kfilipekk/fpga_gps_clock/README.md

# FPGA GPS Clock



A GPS-disciplined OCXO with a picosecond time-to-digital converter on a £15 Sipeed Tang Nano 9K (Gowin GW1NR-9C), built only with open source tools (yosys, nextpnr, apicula, cocotb and SymbiYosys). Made by Krystian Filipek.

## In Plain Terms

Every electronic device keeps time with a tiny vibrating crystal, but cheap crystals drift: they run slightly fast or slow, and change when the temperature changes. This clock checks itself against GPS satellites, which carry atomic clocks, and constantly corrects a much better crystal kept inside a tiny heated oven. Over almost 18 hours its rate wandered by only about one part in three billion, the same as drifting a second every hundred years, from a £15 board and a £4 oscillator.

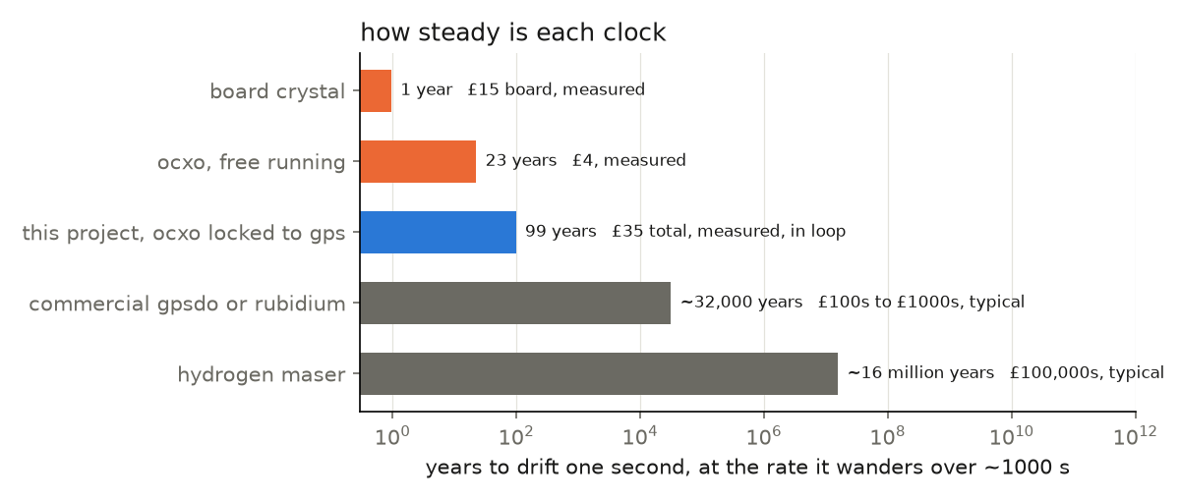
[picture p1: docs/img/compare.png]
How steady is each clock


The board's own crystal also runs about 5 parts per million slow, around 13 seconds a month, about as good as a Casio digital watch (specified to ±30 seconds a month). A fixed offset like that can be measured and corrected, and locked to GPS the OCXO has none. What matters is how much the rate wanders, which is what the chart compares. The orange and blue bars are measured; the grey ones are typical figures for commercial references, for scale.

<div align="center">

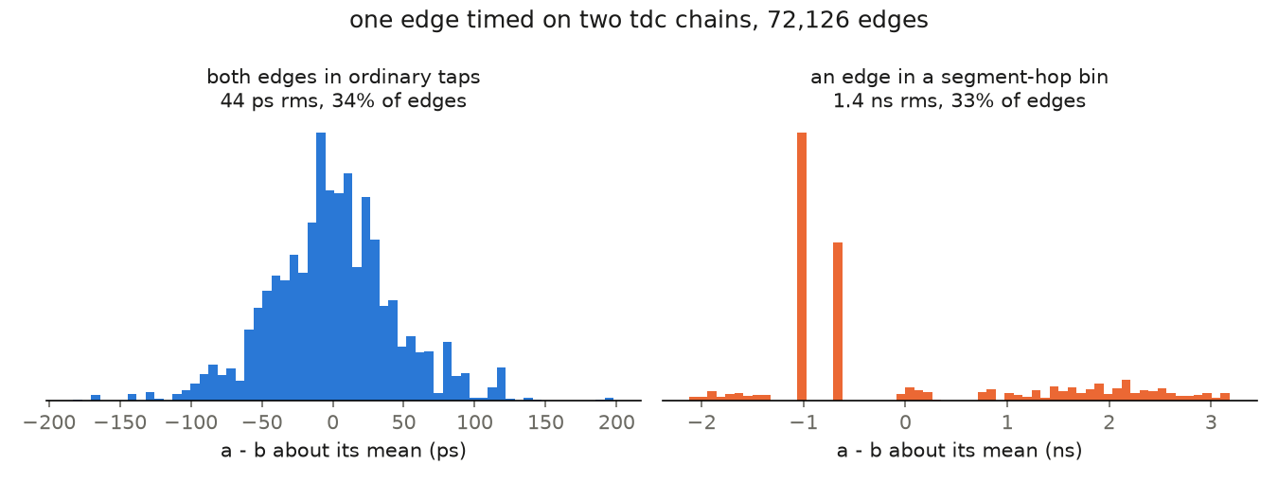
[picture p2: docs/img/tic-precision.png]
Single-shot Precision

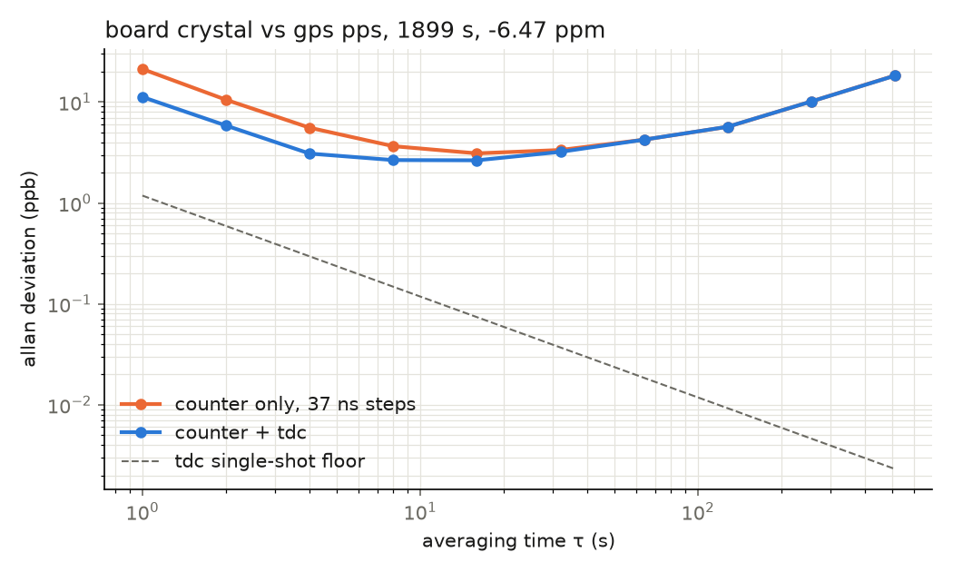
[picture p3: docs/img/pps-adev.png]
Allan Deviation

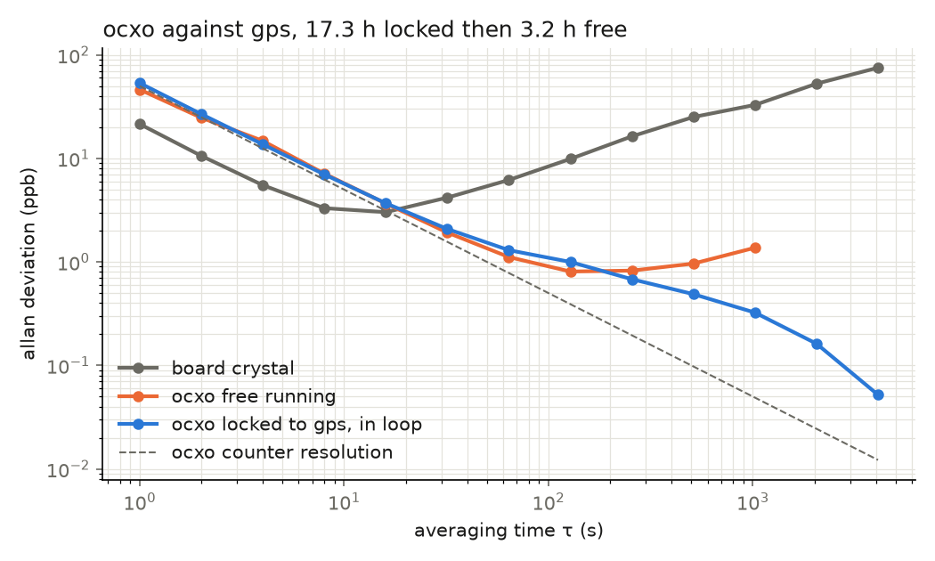
[picture p4: docs/img/ocxo-adev.png]
OCXO Allan Deviation


</div>

## Features

### Measured Performance
| Measurement | Result |
|---|---|
| TDC step, median | 24.6 ps, from the adder carry chain |
| Single-shot precision | ~31 ps rms per channel |
| Crystal stability vs GPS | 11.2 ppb at 1 s, 2.65 ppb floor |
| OCXO locked to GPS | 0.32 ppb at 1024 s, 0.052 ppb at 4096 s, in loop |
| Radio carrier | ±0.21 Hz at 433.92 MHz, no spectrum analyser |
| Upset hardening | 130 of 200 bit flips break lock, 0 with TMR |
| Verification | Formal proofs, 50 cocotb tests, CI on every push |

### Designs
- **gpsdo** - The clock: carry-chain TDC, ring oscillator calibration, GPS cycle counter and a PI loop steering a 10 MHz OCXO
- **extras/ticprec** - The TDC's single-shot precision, one edge timed on two chains
- **extras/xocal** - A CC1101 radio's crystal measured against the clock
- **extras/radio433** - 433 MHz receiver, decoded in fabric and stamped with GPS time
- **docs** - Spec sheet, measurements, verification and roadmap

### Signal Flow
```mermaid
flowchart LR
    gps([GPS 1PPS]) --> cnt[cycle counter<br/>27 MHz]
    gps --> tdc[carry-chain TDC<br/>1200 taps]
    gps --> ocnt[OCXO counter]
    ocxo([10 MHz OCXO]) --> ocnt
    ring([ring oscillator]) -. S1 calibration .-> tdc
    ocnt --> loop[PI loop<br/>optional TMR]
    loop --> dac[sigma-delta DAC] --> ocxo
    cnt --> uart[UART]
    ocnt --> uart
    tdc --> uart
    uart --> host([host: tap LUT,<br/>Allan deviation])
```

Where both chains land in ordinary taps the spread is ~31 ps per channel; where the carry crosses a fabric column one tap is 5 ns wide. Against GPS, the TDC halves the 1 s figure and what is left is the GPS module's own pulse jitter. Locked to GPS over 17.8 hours, the OCXO holds 0.32 ppb at 1024 s, against 1.4 ppb free running and 33 ppb for the board crystal. Every number and the capture behind it is in [docs](docs/README.md).

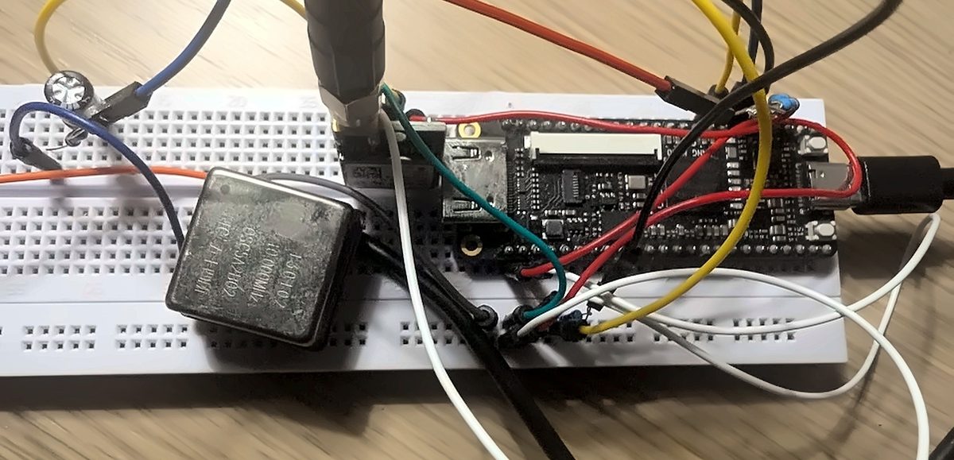
[picture p5: docs/img/bench.jpg]
Bench


The bench: the Tang Nano 9K, the OCXO with its tuning RC, and the GPS antenna's coax.

## Getting Started

### Prerequisites
- **Linux x64** with `git`, `curl` and `make`
- **Sipeed Tang Nano 9K** board
- **GPS module with a 1PPS output** (tested with a u-blox NEO-M8N)
- **10 MHz OCXO with a tuning pin** (tested with a CTI OSC5A2B02), on its own 5 V supply

### Building the Project
1. Clone the repository:
   ```bash
   git clone https://github.com/kfilipekk/fpga_gps_clock.git
   cd fpga_gps_clock
   ```

2. Install the toolchain into `tools/` (nothing is installed globally):
   ```bash
   ./setup.sh
   source tools/oss-cad-suite/environment
   ```

3. Build, test and flash:
   ```bash
   make -C gpsdo          # bitstream
   make -C gpsdo sim      # cocotb
   make -C gpsdo lint     # verilator
   make -C gpsdo formal   # symbiyosys
   make -C gpsdo flash    # load over usb
   ```

Each design has `rtl/`, `sim/`, `host/` for the Python that reads its serial output, and `formal/` where it has proofs. Top level port names must match `mk/tangnano9k.cst`; extra pins go in a design's own cst, named by `CST_EXTRA`.

## Applications

I made this project to explore:
- Sub-nanosecond timing on cheap FPGA fabric
- GPS discipline loops and Allan deviation
- Formal verification and cocotb testing in an open source flow
- Timestamping radio signals against GPS

## Future Plans

- GPS sawtooth correction from the M8N's qErr
- Time the OCXO with the TDC instead of counting cycles, to see below 100 s
- Doppler orbit determination from a recorded satellite pass with an RTL-SDR

<div align="center">

Developed by [kfilipekk](https://github.com/kfilipekk)

</div>
