kfilipekk/fpga_gps_clock/(commit log)

2026-07-19 build flow for the tang nano 9k
2026-07-25 gpsdo: pps period counter over uart
2026-08-02 gpsdo: carry chain tdc
2026-08-03 gpsdo: ring oscillator and code density calibration
    [btn_toggle.v, ring_osc.v]
2026-08-08 gpsdo: top level, period and tap per pps over uart
2026-08-10 gpsdo: wave union and background calibration
2026-08-25 radio433: cc1101 spi config, ook run capture and uart rx
2026-08-29 radio433: nexus frame decode and clean re-encode
2026-09-01 esp32: sensor beacon, replay and receive firmware
2026-09-05 formal: uart and spi proofs
2026-09-11 ticprec: single-shot precision, one edge on two chains
2026-10-14 gpsdo: count the ocxo against gps and steer it
2026-10-14 gpsdo: readme for the ocxo wiring and loop
2026-10-16 host: board crystal from one run, drop thin allan points
2026-10-16 ci: token for the oss-cad-suite download, rate limited
