kfilipekk/fpga_gps_clock/(notices)

Notices in the files:
README.md:
License: MIT
